mike-rankin/ESP32_CoinCell_Color_TFT/Images/Bottom.png

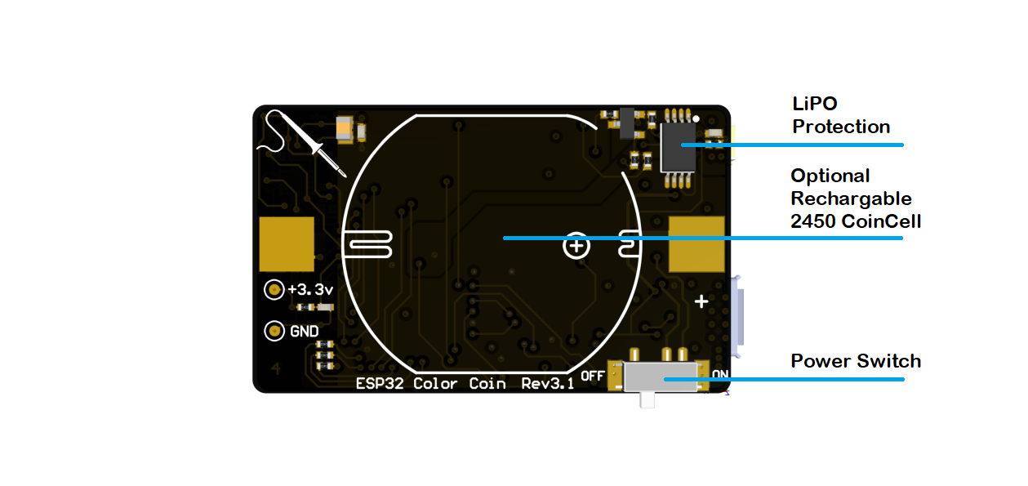
Images/Bottom.png
