mike-rankin/ESP32_CoinCell_Color_TFT/Images/Top.png

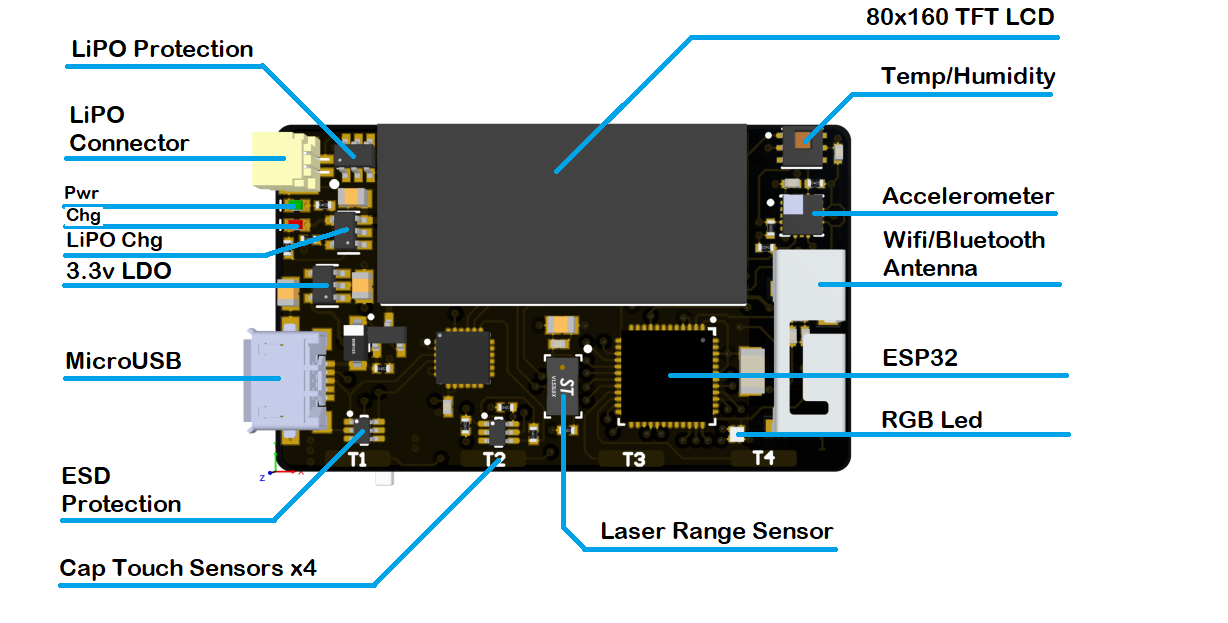
Images/Top.png
