mike-rankin/ESP32_CoinCell_Color_TFT/PCB/Parts_List_Rev3.1.xlsx

Designator | Quantity | Vendor | PartNumber | Description | Manufacturer | Value
ANT1 | 1 | Digi-Key | PRO-OB-440 | RF ANT 2.4GHZ STAMPED MET SLD | Proant AB | RF ANT 2.4GHZ
BAT1 | 1 | Digi-Key | BU2450SM-JJ-GTR | HOLDER,BATT,COIN,24.5MM,SMT | MPD | Coin Cell Holder
C3 | 1 | LCSC | C147344 | CAP 1.5pF 0402 | Dafron | 1.5pF
C4, C5, C8, C14, C16, C17, C19 | 7 | LCSC | C344190 | CAP 0.1uF 0402 | CCTC | 0.1uF
C6 | 1 | LCSC | C87164 | CAP 100uF 6.3V 1206 | Taiyo Yuden | 100uF
C7, C9, C10, C13, C15 | 5 | LCSC | C307520 | CAP 10uF 0805 | Samsung | 10uF
C18 | 1 | LCSC | C83063 | CAP 1uF 16V 0402 | Walsin | 1uF
D1 | 1 | LCSC | C475717 | DIODE SCHOTTKY 20V 500MA | CJ | MBR0520
D2 | 1 | LCSC | C94869 | LED RED CLEAR 0603 SMD | FNO | Red
D3 | 1 | LCSC | C158099 | LED,RGB LED,SMD,RoHS | Foshan | RGB Led
D4 | 1 | LCSC | C125094 | LED Green 0603 | Lite-On | Green
H1 | 1 | LCSC | C21377 | CONN RCPT MICRO USB TYPE AB | REG CON | Micro USB
Q1 | 1 | LCSC | BC847S | TRANS 2NPN 44V 0.1A SC-70-6 | Changjiang | 2NPN
Q2 | 1 | LCSC | C75469 | MOSFET P-CH 20V 2A SOT-23 | On Semi | Mosfet P-H
Q3 | 1 | LCSC | C668969 | TRANSISTOR NPN SOT23 | Micro Commercial | MMBT3904-TP
Q4 | 1 | LCSC | C16052 | MOSFET 2N-CH 20V 6A TSSOP-8L | Fortune | FS8205A
R1, R3, R6, R7, R18, R19 | 6 | LCSC | C258091 | RES 10K 0402 | Guangdong | 10K
R2, R8, R9, R10, R20 | 5 | LCSC | C106235 | RES 1K 0402 | Yageo | 1K
R4 | 1 | LCSC | C8329 | RES 43K 0402 | Uniroyal | 43K
R11 | 1 | LCSC | C25741 | RES 100K 0402 | Uniroyal Elec | 100K
R12, R13 | 2 | LCSC | C100291 | RES 2K 0402 | LIZ Elec | 2K
R14 | 1 | LCSC | C100139 | RES 4.7K 0402 | LIZ Elec | 4.7K
R15 | 1 | LCSC | C25092 | RES 22R 0402 | Uniroyal | 22R
R17 | 1 | LCSC | C106232 | RES 100R 0402 | Yageo | 100R
R21 | 1 | LCSC | C100310 | RES 22K 0402 | LIZ Elec | 22K
S1 | 1 | LCSC | C128955 | SWITCH SLIDE SMD | Korean Hroparts Elec | SWITCH SLIDE
U1 | 1 | LCSC | C47742 | IC BRIDGE USB TO UART 24QFN | Silicon Labs | CP2104N
U2 | 1 | LCSC | C193707 | RF Transceiver ICs QFN-48 | Espressif | ESP32-PICO-D4
U3 | 1 | LCSC | C179747 | TVS SOT-363 RoHS | Yenji | PESD5V0L5UY
U4 | 1 | LCSC | C164106 | IC LDO 3.3V 0.5A SOT23-5 | Holtek | HT7833
U5 | 1 | LCSC | C258510 | Charger IC Lithium-Ion/Polymer | Techfuse | SL4054ST25P
U6 | 1 | LCSC | C15134 | IC ACCEL 2-16G I2C/SPI 16LGA | STMicro | LIS3DHTR
U7 | 1 | LCSC | C82227 | Humidity/Temperature Sensor | Texas Instruments | HDC1080DMBT
U8 | 1 | LCSC | C351410 | IC LITHIUM BATT PROTECT | PUOLOP | DW01A
U9 | 1 | LCSC | C91199 | LASER SENSOR | ST MICRO | VL53L0CXV0DH/1
X1 | 1 | BuyDisplay | ER-TFT0.96-1 | 0.96 INCH TFT GLASS COLOR | BuyDisplay
