mike-rankin/ESP32_CoinCell_Color_TFT/(threads)

Thread 1 (2020-11-03):

Hardware design questions

patfelst, 2020-11-03:
Hi this is a great project, thanks for sharing. I have a few questions about the h/w design:

1. Why did you change the USB-Serial chip to CP2104, as it is not recommended for new designs?
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

On the CP2102, the REGIN (pin 7) and VDD (pin 6) can also be connected to disable the onboard regulator. It still looks like you've been able to reduce the number of passives with the CP2104, e.g. no reset pullup.

2. Surprised how few high freq bypass caps (e.g. 100nF) you have (none!) for the ESP32? Did you determine they aren't needed through trial and error? You just have the single large 100uF cap.

3. Wondering how you can replace the inductor in the antenna matching circuit with a cap?

Thanks in advance!

mike-rankin, 2020-11-04:
Older revisions used the CP2102 but it needed many more capacitors and resistors around it and is physically much larger. Had no idea that the 2102 is not recommended for new designs. Thanks for the tip!
On my next revision I'll add more decoupling capacitors around the CP2102 and will try and fit in more capacitors for the ESP32. Right now the board is so tiny and four layers that I lucked out. On larger four layer boards I have several 150uF electrolytic hanging off the pawer pins.
For the antenna it looks like capacitors of a small value in series look correct: https://dl.espressif.com/dl/schematics/esp32-pico-kit-v4_schematic.pdf and https://github.com/tinypico/tinypico-hardware/blob/master/TinyPICO%20Release%20P3/TinyPICO_Schematic.pdf

patfelst, 2020-11-04:
Thanks for that. The CP2102 also comes in a QFN24 package which is pin compatible with the CP2104.

Thanks for the links, the matching network does indeed have a different topology than others I've seen. But I guess if all 3 matching components use the same 0402 (or 0603) footprint then you can choose whatever topology you want during assembly.

If you look at the PICO-D4 "module" schematic (i.e. inside the chip), it has a built-in matching network (see yellow circle below), and also bypass caps (see cyan circle below), so you probably don't need an antenna matching network, and is probably why you're getting away with no decoupling caps (and an inductor noise filter).
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

Anyway all the best, great work once again.

mike-rankin, 2020-11-05:
Thanks for the 24pin CP2102N tip. I've only used the 28pin version in the past and will order the 24pin version to see if it works well as a drop in sub. It's great that the ESP32 pico has taken car eof so many things internally. I'm working with the nRF52 now it is very unforgiving if you don't really know what you are doing.

Closed 2020-11-05.

Thread 2 (2020-11-13):

PCB file in Eagle or EasyEDA

happytm, 2020-11-13:
Mike,

As usual fantastic design. I wanted to edit your project for my custom needs.

Would you please be kind to publish PCB (board) file in either Eagle format or EasyEDA format ?

Thanks.

mike-rankin, 2020-11-13:
Glad you like the project. It was really fun to get it to where it is now and is always improving. Unfortunately I am only familiar with Altium Designer and have never used Eagle or EasyEDA. Hopefully your software will be able to import Altium files.

happytm, 2020-11-15:
Is it possible to get rid of usb interface ? If so what pins should be brought to standard 2.54 connector so I can directly plug in the Programmer linked below:

 https://www.newegg.com/p/2S7-06CR-01Z53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

Thanks.

mike-rankin, 2020-11-16:
It is possible on the next revision to get rid of the usb interface but the 24 pin QFN part is quite small as is and the large usb connector would still be needed to charge the battery. For the Newegg programmer that you mention, I'd have to test it on a custom board to verify that only the +3.3V, GND, Rx, Tx, RTS and DTR pins are pins are needed.

happytm, 2020-11-16:
Thank you for your quick reply.

Please keep it up.
