mike-rankin/ESP32_CoinCell_Color_TFT/PCB/Schematic_Rev3.1.pdf

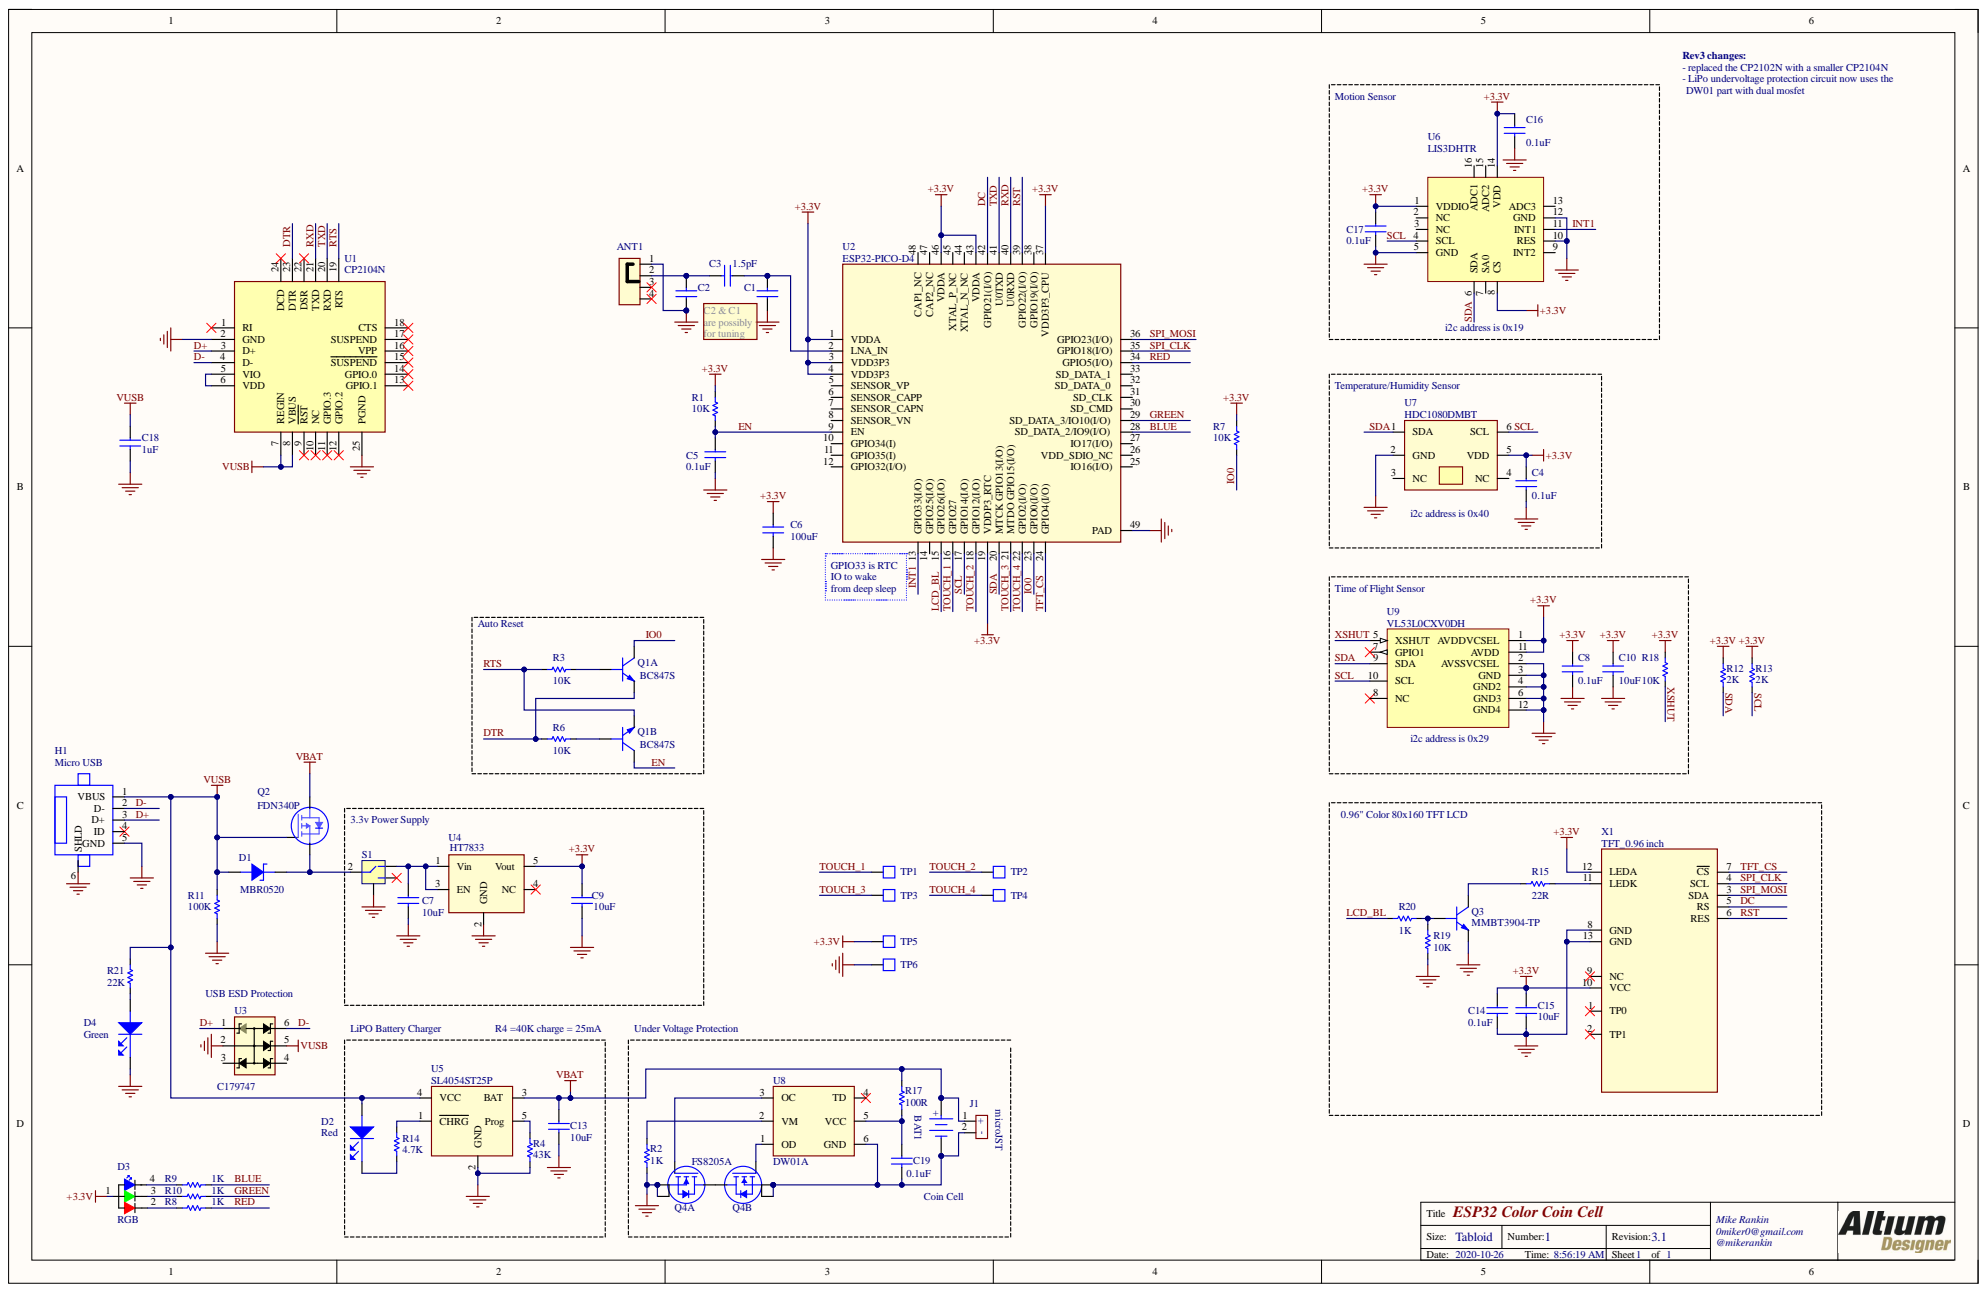
[picture p3: page 1]

Rev3 changes:
- replaced the CP2102N with a smaller CP2104N
- LiPo undervoltage protection circuit now uses the
DW01 part with dual mosfet

RTS 19 RXD 20 TXD 21 DSR 22 DTR 23

Time of Flight Sensor

GND 13
