mike-rankin/ESP32_CoinCell_Color_TFT/PCB/Bottom_Assembly.pdf

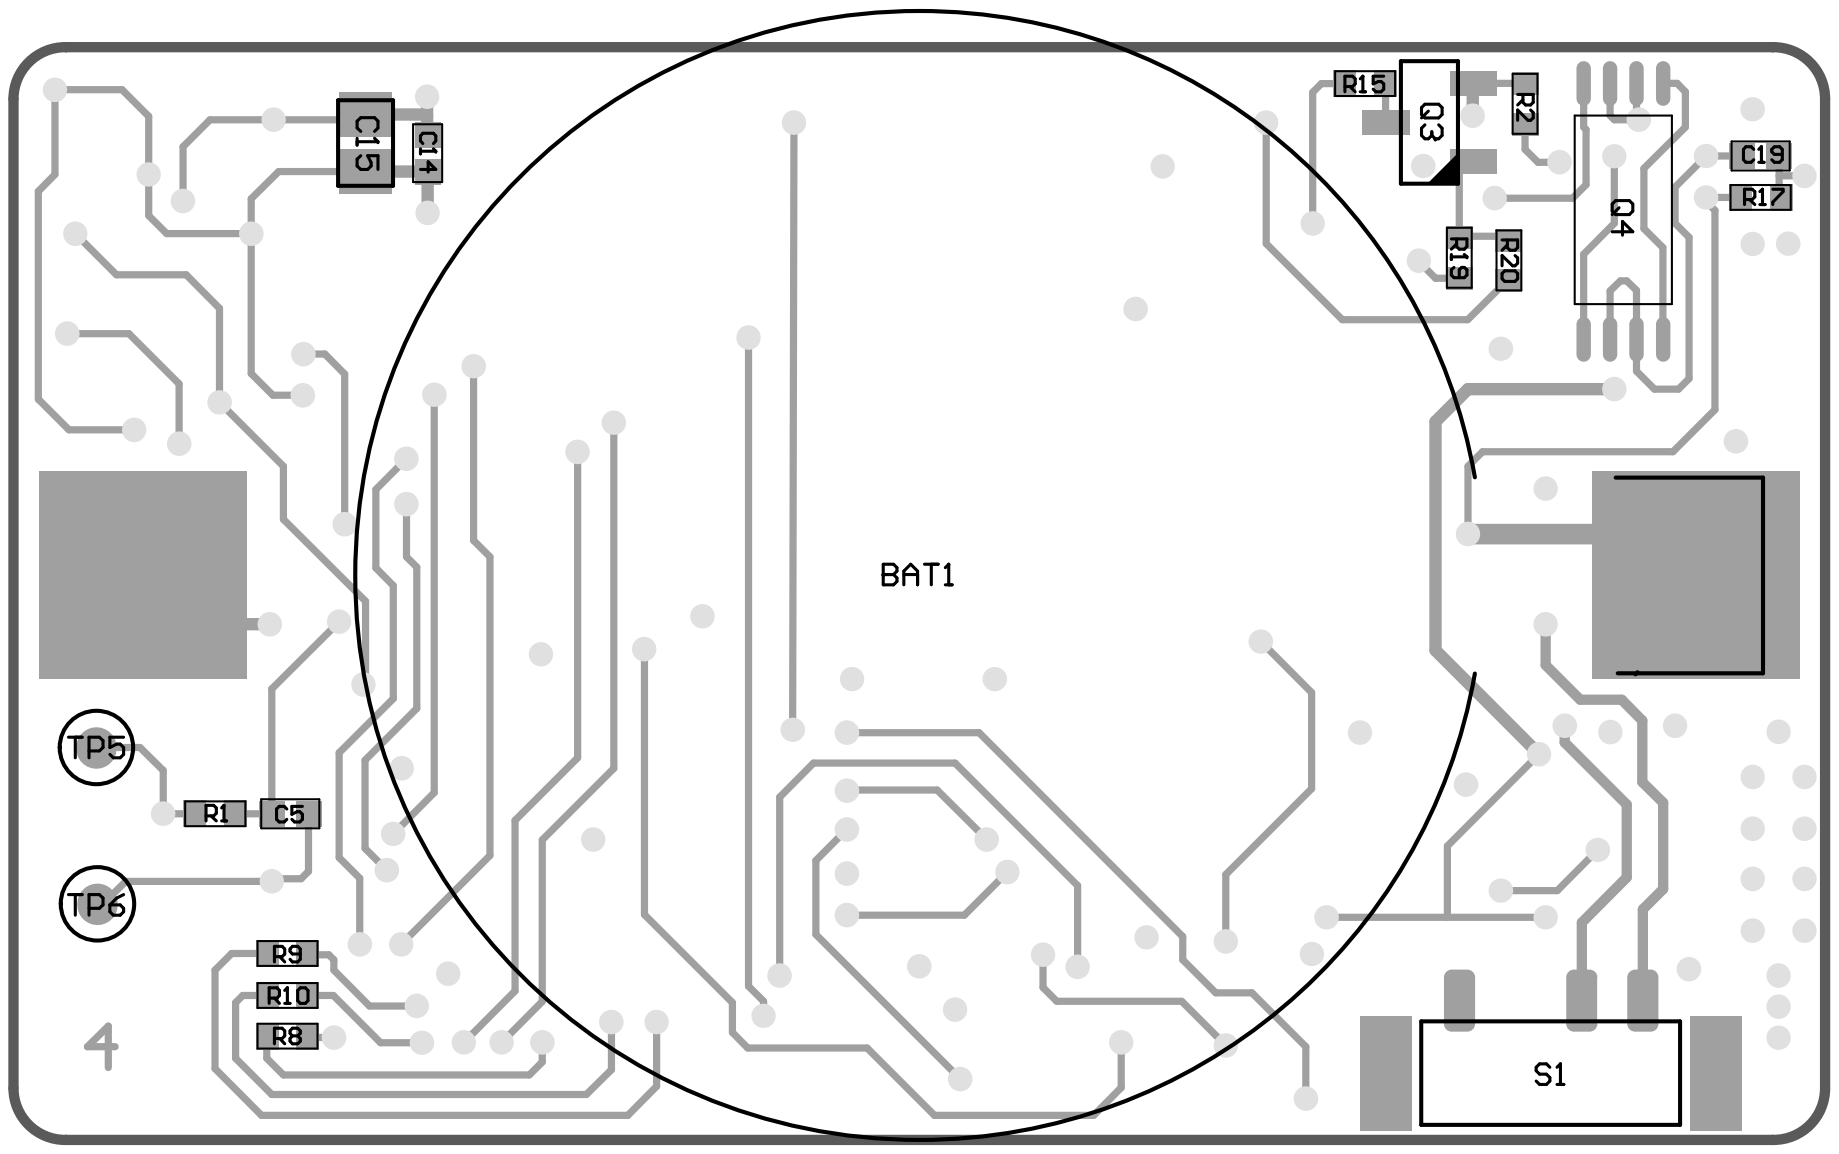
[picture p4: page 1]
