mike-rankin/ESP32_CoinCell_Color_TFT/PCB/Top_Assembly.pdf

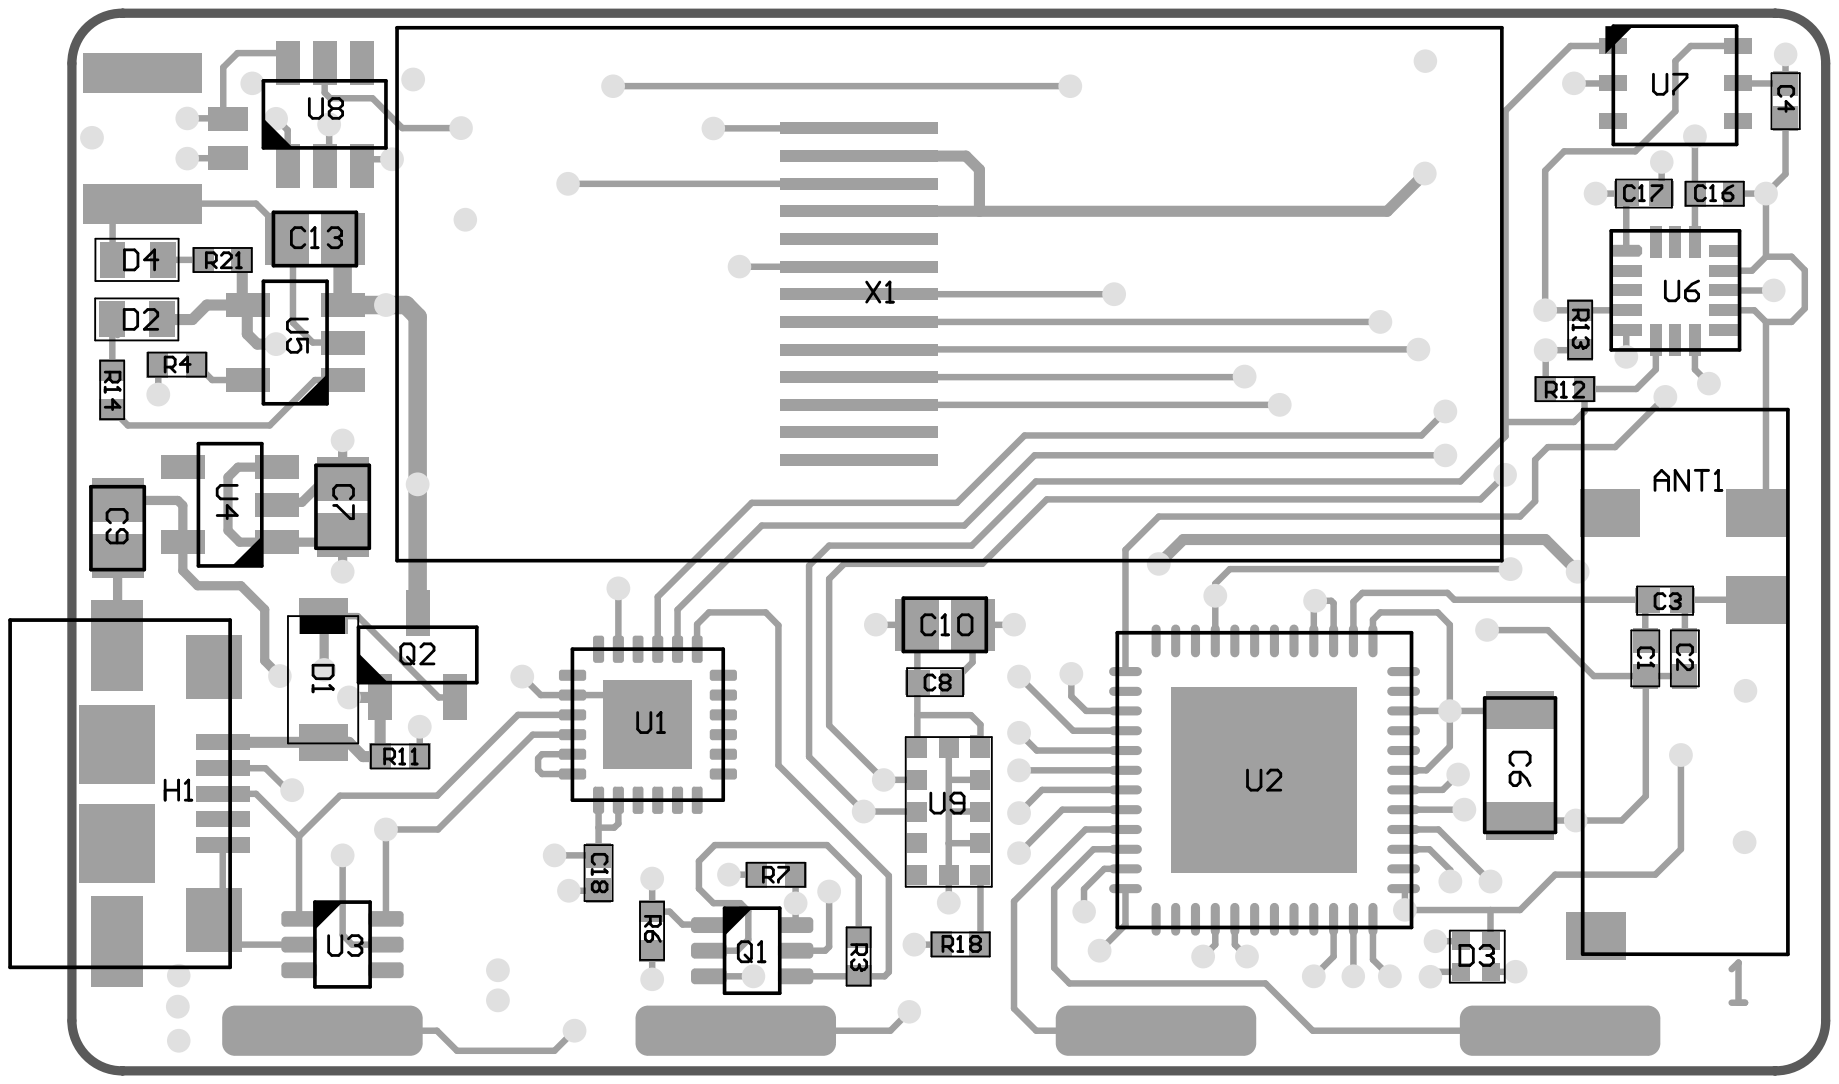
[picture p5: page 1]
