mike-rankin/ESP32_CoinCell_Color_TFT/Code/Clock_and_Weather/icons.h

/*  Create C arrays from jpeg images using this online tool:
    http://tomeko.net/online_tools/file_to_hex.php?lang=en

    If needed, first resize and crop to an appropriate width and height
    to suit your display with an image editting program such as IrfanView.
    
    You can also change the image "guality" to reduce the file size.
    
    Paste the array into a new tabe, top and tail the array from the
    tool to look like the one below with:

    #include <pgmspace.h>
    const uint8_t name[] PROGMEM = {

    to start and and end with:

   };

    Change the name of the array. Make sure the original jpeg is less than 32Kbyes
    as there is an array size limit imposed by the Arduino IDE!


*/

#include <pgmspace.h>
const uint8_t sun[] PROGMEM = 
{

0xFF, 0xD8, 0xFF, 0xE0, 0x00, 0x10, 0x4A, 0x46, 0x49, 0x46, 0x00, 0x01, 0x01, 0x01, 0x00, 0xC0, 
0x00, 0xC0, 0x00, 0x00, 0xFF, 0xDB, 0x00, 0x43, 0x00, 0x02, 0x01, 0x01, 0x02, 0x01, 0x01, 0x02, 
0x02, 0x02, 0x02, 0x02, 0x02, 0x02, 0x02, 0x03, 0x05, 0x03, 0x03, 0x03, 0x03, 0x03, 0x06, 0x04, 
0x04, 0x03, 0x05, 0x07, 0x06, 0x07, 0x07, 0x07, 0x06, 0x07, 0x07, 0x08, 0x09, 0x0B, 0x09, 0x08, 
0x08, 0x0A, 0x08, 0x07, 0x07, 0x0A, 0x0D, 0x0A, 0x0A, 0x0B, 0x0C, 0x0C, 0x0C, 0x0C, 0x07, 0x09, 
0x0E, 0x0F, 0x0D, 0x0C, 0x0E, 0x0B, 0x0C, 0x0C, 0x0C, 0xFF, 0xDB, 0x00, 0x43, 0x01, 0x02, 0x02, 
0x02, 0x03, 0x03, 0x03, 0x06, 0x03, 0x03, 0x06, 0x0C, 0x08, 0x07, 0x08, 0x0C, 0x0C, 0x0C, 0x0C, 
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
0xE3, 0xE4, 0xE5, 0xE6, 0xE7, 0xE8, 0xE9, 0xEA, 0xF2, 0xF3, 0xF4, 0xF5, 0xF6, 0xF7, 0xF8, 0xF9, 
0xFA, 0xFF, 0xDA, 0x00, 0x0C, 0x03, 0x01, 0x00, 0x02, 0x11, 0x03, 0x11, 0x00, 0x3F, 0x00, 0xFC, 
0x0F, 0x27, 0xFB, 0x16, 0x01, 0x8C, 0x7D, 0xAE, 0x41, 0x93, 0xC7, 0xFA, 0x95, 0x23, 0x20, 0x83, 
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

};
