mike-rankin/ESP32_CoinCell_Color_TFT/Code/Splashscreen/logo.h

// width x height = 100,100
//static const uint8_t logo[] PROGMEM = {
	
//const unsigned char logo[] PROGMEM = //this line works
const uint16_t PROGMEM logo[] =      //might work
{


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


};
