mike-rankin/ESP32_CoinCell_Color_TFT/(commit log)

2019-09-21 Fixed a few issues, updated to new bb_spi_lcd library
    [colorcoin_test.ino]
2019-09-26 Added images and Parts List
    [Parts_List_Rev2.xls]
2020-04-06 Fixed for changes to dependent libraries
    [colorcoin_test.ino]
2020-10-26 Updated Revision Files
    [Parts_List_Rev2.xls, Parts_List_Rev3.1.xlsx]
2020-10-30 added sleep current test sketch
